autr/neu-dsk/hardware/schematic.pdf

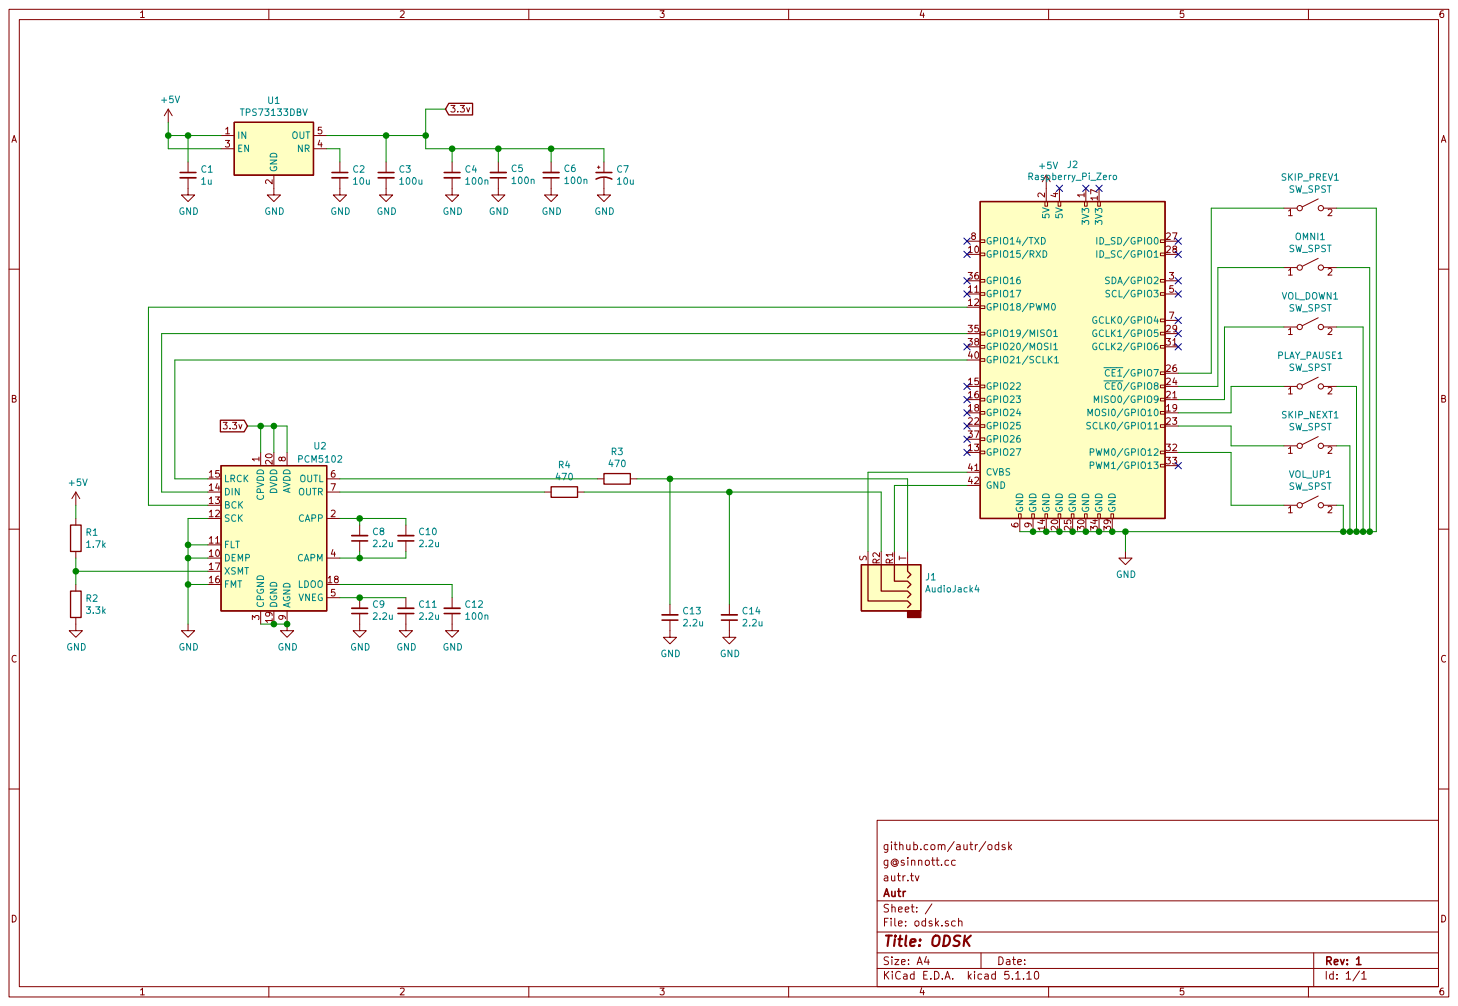
[picture p1: page 1]

4 GPIO21/SCLK1 40 CVBS 41 GND 42 SCL/GPIO3 5 GND

1 DEMP 10 FLT 11 SCK 12 BCK 13 DIN 14

3 CAPM 4 VNEG 5 OUTL 6 OUTR 7 AVDD

github.com/autr/odsk
File: odsk.sch Sheet: / Autr autr.tv g@sinnott.cc
