autr/neu-dsk/hardware/odsk.kicad_pcb

## KiCad design hardware/odsk.kicad_pcb (2022-07-06)

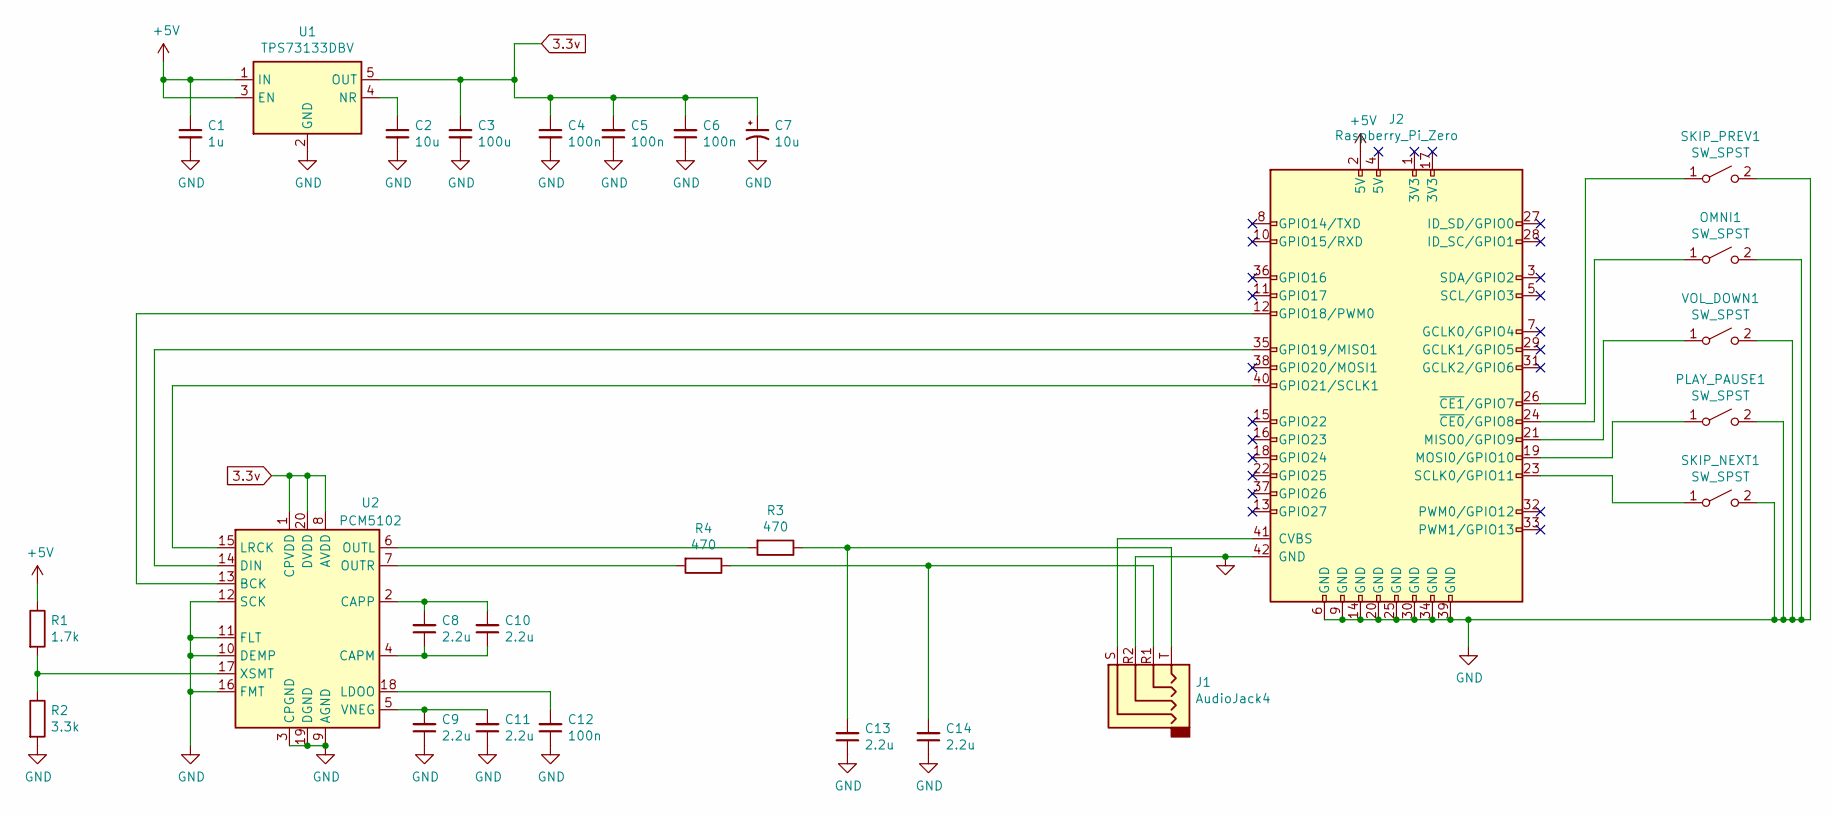
[picture p2: schematic odsk.kicad_sch]

Parts:
C1: 1u; C_0805_2012Metric_Pad1.18x1.45mm_HandSolder
C2: 10u; C_0805_2012Metric_Pad1.18x1.45mm_HandSolder
C3: 100u; C_1206_3216Metric_Pad1.33x1.80mm_HandSolder
C4, C5, C6, C12: 100n; C_0805_2012Metric_Pad1.18x1.45mm_HandSolder
C7: 10u; CP_Elec_5x5.4
C8, C9, C10, C11, C13, C14: 2.2u; C_0805_2012Metric_Pad1.18x1.45mm_HandSolder
J1: AudioJack4; TRRS-PJ-320A-Jack
J2: Raspberry_Pi_Zero
OMNI1: SW_SPST; SW_Tactile_SPST_Angled_PTS645Vx39-2LFS
PLAY_PAUSE1: SW_SPST; SW_Tactile_SPST_Angled_PTS645Vx39-2LFS
R1: 1.7k; R_0805_2012Metric_Pad1.20x1.40mm_HandSolder
R2: 3.3k; R_0805_2012Metric_Pad1.20x1.40mm_HandSolder
R3, R4: 470; R_0805_2012Metric_Pad1.20x1.40mm_HandSolder
SKIP_NEXT1: SW_SPST; SW_Tactile_SPST_Angled_PTS645Vx39-2LFS
SKIP_PREV1: SW_SPST; SW_Tactile_SPST_Angled_PTS645Vx39-2LFS
U1: TPS73133DBV; SOT-23-5
U2: PCM5102; TSSOP-20_4.4x6.5mm_P0.65mm
VOL_DOWN1: SW_SPST; SW_Tactile_SPST_Angled_PTS645Vx39-2LFS

Connections:
3.3v: C3.1, C4.1, C5.2, C6.2, C7.1, U1.5 (OUT), U2.1 (CPVDD), U2.8 (AVDD), U2.20 (DVDD)
+5V: C1.1, J2.2 (5V), R1.1, U1.1 (IN), U1.3 (EN)
unnamed: C2.1, U1.4 (NR)
unnamed: C8.1, C10.1, U2.4 (CAPM)
unnamed: C8.2, C10.2, U2.2 (CAPP)
unnamed: C9.2, C11.2, U2.5 (VNEG)
unnamed: C12.2, U2.18 (LDOO)
unnamed: C13.2, J1.T, R3.1
unnamed: C14.2, J1.R1, R4.1
unnamed: J1.S, J2.41 (CVBS)
unnamed: J2.12 (GPIO18/PWM0), U2.13 (BCK)
unnamed: J2.19 (MOSI0/GPIO10), PLAY_PAUSE1.1 (A)
unnamed: J2.21 (MISO0/GPIO9), VOL_DOWN1.1 (A)
unnamed: J2.23 (SCLK0/GPIO11), SKIP_NEXT1.1 (A)
unnamed: J2.24 (~CE0/GPIO8), OMNI1.1 (A)
unnamed: J2.26 (~CE1/GPIO7), SKIP_PREV1.1 (A)
unnamed: J2.35 (GPIO19/MISO1), U2.14 (DIN)
unnamed: J2.40 (GPIO21/SCLK1), U2.15 (LRCK)
unnamed: R1.2, R2.1, U2.17 (XSMT)
unnamed: R3.2, U2.6 (OUTL)
unnamed: R4.2, U2.7 (OUTR)

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
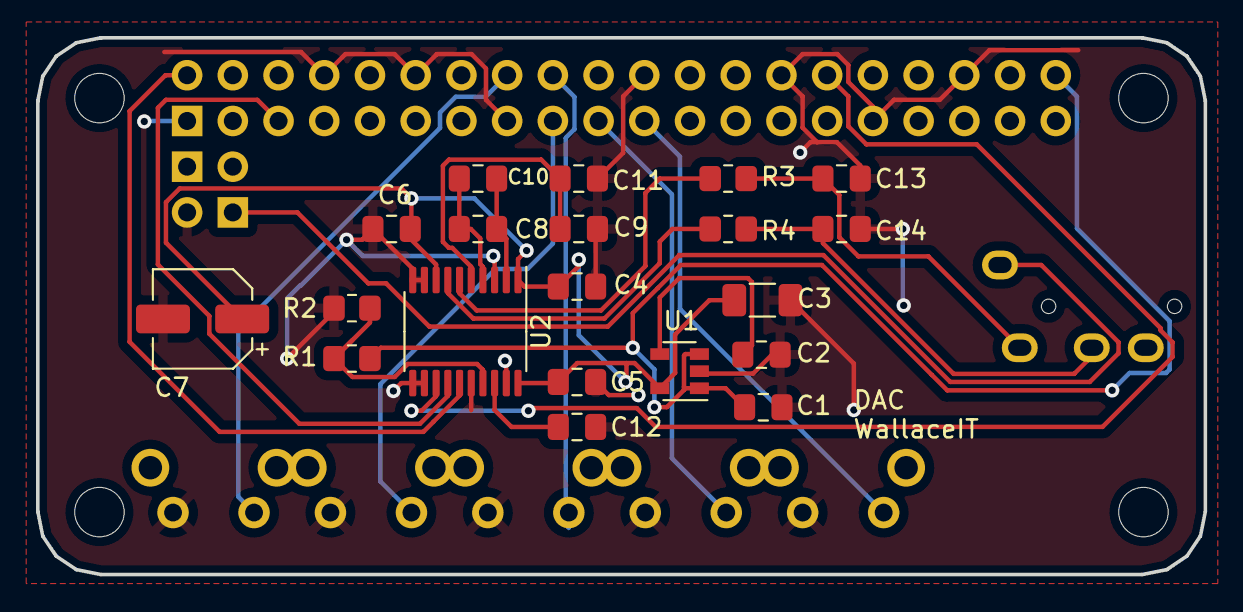
[picture p3: board odsk.kicad_pcb from above]

Board: 2 copper layers, 64.9 x 29.8 mm, 27 parts (0 on the bottom side), 22 nets.
