autr/neu-dsk/zero/index.js

const fs = require('fs')
const path = require('path')
const { spawn, execSync, exec }  = require('child_process')
const keypress = require('keypress')
const template = require('./template.svg.js')
const MODES = require('./modes.js')
const minimist = require('minimist')
const os = require('os')
const RPiGPIOButtons = require('rpi-gpio-buttons') 
const TESTCMD = `omxplayer --vol 1000 -b -o alsa:hw:0,0 /home/dietpi/dsk/samples/001.mov`
const mime = require('mime')
const InputEvent = require('input-event')

console.log(`[odsk] 👤  ${os.userInfo().username} ${process.env.USER || ''}`)

const INFO_RESTART = 0
const INFO_NO_CONFIG = 1

let ARGS = minimist( process.argv.slice(2) ) 

const VOLUP = 'VOLUP' 
const VOLDOWN = 'VOLDOWN'
const OMNI = 'OMNI'
const SKIPNEXT = 'SKIPNEXT'
const SKIPPREV = 'SKIPPREV'
const PLAYPAUSE = 'PLAYPAUSE'

let ENDOFDAYS = false // pi is rebooting
let KEYBOARDED = false // pi has keyboard attached

let DEBUG = ARGS?.d || false // dont reboot or show player
let FORCE = ARGS.f // force rerendering overlays

let IDX = 0 // video index
let PROC = null // video process

let VOL = -300 // current volume (read from disk)
let VOL_MIN = -4800 
let VOL_MAX = 0

let LIST = [] // list of video files
let GAP = 5000 // pause between files (read from disk)
let SPLASH = 'odsk' // boot splash (read from disk)
let TIMEOUT = null // overlay timeout
let MODE = 0 // video mode (read from disk)

const KEYS = {
    105: SKIPPREV,
    106: SKIPNEXT, 
    103: VOLUP,
    108: VOLDOWN,
    57: PLAYPAUSE,
    28: OMNI
}

console.log( `[odsk] 👁  commandline args ${JSON.stringify(ARGS)}`)

const BTNS = {
    12: VOLUP, // up
    9: VOLDOWN, // down
    8: OMNI, // enter
    11: SKIPNEXT, // right 
    10: PLAYPAUSE, // space
    7: SKIPPREV // left
}

console.log( `[odsk] 👁  using pins ${Object.keys(BTNS).join(',')}`)

let CMDS = {
    player: e => process.platform == 'darwin' ? 'mplayer' : 'omxplayer',
    settings: e => process.platform == 'darwin' ? '' : `-b --vol ${VOL} -o alsa:hw:0,0`
}
if ( !ARGS._[0] ) return console.error('[odsk] ❌  exiting - no folder specified')
let ROOT = path.resolve( ARGS._[0] )
let BIN = path.resolve( ROOT, './.bin' )
const DIRS = {
    ROOT,
    BIN,
    VOL: path.resolve( BIN, './volume.txt'),
    TIMEOUT: path.resolve( BIN, './timeout.txt'),
    SPLASH: path.resolve( BIN, './splash.txt')
}


const config = async e => {

    const str = await (await fs.readFileSync( `/boot/config.txt` )).toString()

    const a = str.indexOf(STR.BEGIN)
    const b = str.indexOf(STR.END) + STR.END.length
    const found = !(b < a || a == -1 || b == -1)

    return { a, b, found, str }
}


const save = async e => {

    ENDOFDAYS = true

	if (KEYBOARDED) {
		try {

   			keyboard.removeListener('keyup', onKeyup)
    		keyboard.removeListener('keypress', onKeypress)
		} catch(err) {}
	}

    let { str, found, a, b } = await config()

    let mode = MODES[MODE]
    let txt = mode.text

    if ( mode.type == 'CUSTOM' ) {
        let custom = path.resolve(ROOT, 'custom.txt')
        if ( await fs.existsSync( custom ) ) {
            mode.code = (await fs.readFileSync( custom )).toString()
            console.log(`[odsk] 🛠  using custom mode\n`, txt)
        } else {
            console.warn(`[odsk] ❌  could not find a custom.txt at ${custom}`)
            return (await show( 'info', INFO_NO_CONFIG ))

        }
    }

    let neu = `${STR.BEGIN}
${STR.MODE}${MODE}
# ${txt.replaceAll('\n', ' - ')}
${mode.code}
${STR.END}`
    let piece
    if (!found) {
        str += neu 
    } else {
        piece = str.substring(a, b)
        str = str.replace(piece, neu)
    }

    const ending = s => (s.substring( s.length - 40, s.length ))

    await fs.writeFileSync( '/boot/config.txt', str )
    console.log(`[odsk] 🗳  wrote mode ${MODE} to boot config\n`, neu)

    await KILL.player()

    // TODO: this is a hacky fix
    
    await show('info', INFO_RESTART)
    
    setTimeout( async e => {
        console.log(`[odsk] ⚡️  rebooting now`)
        if (!DEBUG) await execSync(`sudo reboot now`) 
    }, GAP)
}


async function onReleased( PIN ) {

    if (ENDOFDAYS) return

    console.log(`[odsk] ❄️  released ${PIN.toLowerCase()}`)
    if ( PIN == OMNI ) {
        clearTimeout( RESET_TIMEOUT )
        MODE_TOGGLE = !MODE_TOGGLE
        await modish( 0 )
        await KILL.player()
    }
}

let RESET_TIMEOUT = null
const RESET_TIME = 4500


async function onPressed( PIN ) {

    if (ENDOFDAYS) return

    console.log(`[odsk] 🔆  pressed ${PIN.toLowerCase()}`)

    if ( PIN == SKIPPREV ) {
        if (!MODE_TOGGLE) await skip(-1)
        if (MODE_TOGGLE) await modish(-1)
    }
    if ( PIN == SKIPNEXT ) {
        if (!MODE_TOGGLE) await skip(1)
        if (MODE_TOGGLE) await modish(1)
    }

    if ( PIN == VOLDOWN || PIN == VOLUP ) {
        if (!MODE_TOGGLE && PROC) {
            if ( PIN == VOLDOWN && VOL >= VOL_MIN + 300 ) {
                VOL -= 300
                console.log(`[o-disk] 🔊  ${VOL/1000}db ${VOL}`)
                await PROC.stdin.write('-')
            }
            if ( PIN == VOLUP && VOL <= VOL_MAX - 300 ) {
                VOL += 300
                console.log(`[o-disk] 🔊  ${VOL/1000}db ${VOL}`)
                await PROC.stdin.write('+')
            }
            await fs.writeFileSync( DIRS.VOL, VOL + '' )
        } else {
            // if ( PIN == VOLDOWN ) await modish(-1)
            // if ( PIN == VOLUP ) await modish(1)
        }
    }

    if ( PIN == PLAYPAUSE ) {
        if (PROC) await PROC.stdin.write(' ')
        if (!PROC && MODE_TOGGLE) {
            console.log('[o-disk] 🛰  saving settings')
            await save()
        }
    }

    if ( PIN == OMNI ) {
        if (!PROC) clearTimeout(TIMEOUT)
        RESET_TIMEOUT = setTimeout( async e => {
            console.log('[o-disk] 🛰  pressed and held - 720p / NTSC')
            MODE = 0
            await save()
        }, RESET_TIME)
    }


}

const gpio = async e => {

    let buttons = new RPiGPIOButtons( { 
        pins: Object.keys(BTNS),
        mode: RPiGPIOButtons.MODE_BCM,
        usePullUp: false,
        debounce: 10,
        pressed: 10,
        clicked: 10
    })
    buttons.on('error', async err => ( console.log('[odsk] 🚨  button error', err) ))
    buttons.on('pressed', pin => onReleased(BTNS[pin]))
    buttons.on('released', pin => onPressed(BTNS[pin]))
    buttons.init().catch(err => ( console.error('[odsk] ❌  error initialising buttons:', err.message)))
}

try {

    const keyboard = new InputEvent.Keyboard( new InputEvent('/dev/input/event0') ) 

    async function onKeyup(e) {
        if (ENDOFDAYS) return
        console.log(`[odsk] 🎹  keyup ${KEYS[e.code]}`)
        onReleased( KEYS[e.code] )
    }

    async function onKeypress(e) {
        if (ENDOFDAYS) return
        console.log(`[odsk] 🎹  keypress ${KEYS[e.code]}`)
        onPressed( KEYS[e.code] )
    }

    keyboard.on('keyup', onKeyup)
    keyboard.on('keypress', onKeypress)

    KEYBOARDED = true

} catch(err) {
    console.log(`[odsk] 🌶  no keyboard attached ${err.message}`)
}

console.log(`[odsk] 🛣  using paths\n------------`)
Object.entries(DIRS).forEach( o => ( console.log(`${o[0]} ${o[1]}\n------------`) ) )

const KILL = {
    fbi: async e => {
        console.log('[odsk] ⚰️  killing framebuffer')
        try { 
            await execSync( `sudo pkill fbi`) 
        } catch(err) {}
    },
    node: async e => {
        console.log('[odsk] ⚰️  killing node')
        try {  
            await execSync( `sudo pkill node`)
        } catch(err) {}
    },
    player: async e => {
        console.log('[odsk] ⚰️  killing player')
        try { 
            await execSync( `pkill ${CMDS.player()}`) 
        } catch(err) {}
    }
}

const skip = async num => {
    IDX += num
    if (IDX < 0) IDX = LIST.length - 1
    if (IDX >= LIST.length) IDX = 0
    console.log(`[odsk] ⏳  switched to ${IDX}/${LIST.length}` )
    await start()

}
const toggle = async e => {
    console.log('[odsk] 🏁  pause / play')
    if (PROC) PROC.stdin.write(' ')
}


const show = async (type, idx) => {


    await KILL.fbi()
    let img = `${type}-${idx}.png`
    console.log(`[odsk] 🖼  displaying ${img}`)
    if (!DEBUG) await execSync( `sudo fbi -d /dev/fb0 -T 1 --nocomments --noverbose --cachemem 1 ${path.resolve(DIRS.BIN, `${img} > /dev/null 2>&1`)}`)
}

let MODE_TOGGLE = false

const modish = async num => {
    MODE += num
    if (MODE < 0) MODE = MODES.length - 1
    if (MODE >= MODES.length) MODE = 0
    if (MODE_TOGGLE) {
        await show('mode', MODE)
        await KILL.player()
    } else {
        await start()
    }
}

const start = async e => {

    if (TIMEOUT) {
        clearTimeout( TIMEOUT )
        TIMEOUT = null
    }

    await KILL.player()
    await show('video', IDX)

    PROC = null

    TIMEOUT = setTimeout( async ee => {

        const url = path.resolve(DIRS.ROOT, LIST[IDX].name )
        let ex = `${CMDS.player()} ${CMDS.settings()} ${url}`

        console.log(`[odsk] 🎬  playing ${ path.basename(url) }`)
        console.log(`[odsk] 🎬  ${ex}`)

        if (!DEBUG) {

            PROC = exec( ex, async (error, stdout, stderr) => {

                if (ENDOFDAYS) return

                const data = {error,stdout,stderr}
                let type = error ? 'error' : stdout ? 'stdout' : stderr ? 'stderr' : ''
                const o = data[type]
                if (type == 'error') type = 'exited'
                console.log(`[${CMDS.player()}] 📼   player ${type}`, o.code, o.killed || '', o.signal || '' )
     
                PROC = null
                if (type == 'stdout') {
                    console.log(`[${CMDS.player()}] 📼   skipping to next from stdout`)
                    await skip(1)
                }
            })
        }

    }, GAP)

}

const create = async (type, list, PLYMOUTH) => {

    if (ENDOFDAYS) return

    let count = 0
    for (let i = 0; i < list.length; i++ ) {
        const o = list[i]
        const markup = template(o.text)
        let svg = path.resolve(DIRS.BIN, `${type}-${i}.svg` )
        let png = path.resolve(DIRS.BIN, `${type}-${i}.png` )

        if (PLYMOUTH) {
            svg = '/usr/share/plymouth/themes/pix/splash.svg'
            png = '/usr/share/plymouth/themes/pix/splash.png'
            console.log(`[odsk] 🍇  using plymouth ${png}`)
        }

        let hasChanged = false

        if (await fs.existsSync(svg)) {
            const s = await ( await fs.readFileSync( svg ) ).toString()
            hasChanged = markup != s
        } else {
            hasChanged = true
        }

        if (!(await fs.existsSync( png )) || FORCE || hasChanged ) {
            const cmd = `MAGICK_FONT_PATH=/usr/share/fonts/truetype/custom rsvg-convert ${svg} > ${png}` 
            await fs.writeFileSync( svg, markup )
            await execSync( cmd )
            console.log(`[odsk] 🖼  ${png}`)
            count += 1
        }



    }
    if (count > 0) console.log(`[odsk] ✅  ${count} new ${type} overlays`)
}

let STR = {
    BEGIN: '# <DSK>',
    END: '# </DSK>',
    MODE: '# MODE='
}

const patch = async e => {
    const res = (await execSync('python ../libs/buttons.py')).toString()
    console.log(`[odsk] 🐍  gpio buttons patch: ${res.replaceAll('\n', ' ')}`)
}
const wait = async ms => ( new Promise(resolve => setTimeout(resolve, ms) ) )

const run = async e => {


    await KILL.fbi()
    await KILL.player()
    await gpio()
    await patch()

    // await wait(1000)

    // let PINS = Object.keys(BTNS)
    // for (let i = 0; i < PINS.length; i++){
    //     let PIN = PINS[i]
    //     console.log(`[odsk] ♻️  refreshing pin ${PIN}`)
    //     let cmds = {
    //         unexport: `echo ${PIN} > /sys/class/gpio/unexport`,
    //         export: `echo ${PIN} > /sys/class/gpio/export`,
    //         direction: `echo in > /sys/class/gpio/gpio${PIN}/direction`
    //     }
    //     try { await execSync( cmds.unexport ) } catch(err) { console.error('[odsk] ❌ ', err.message) }
    //     try { await execSync( cmds.export ) } catch(err) { console.error('[odsk] ❌ ', err.message) }
    //     try { await execSync( cmds.direction ) } catch(err) { console.error('[odsk] ❌ ', err.message) }
    // }

    if ( !(await fs.existsSync( DIRS.BIN )) ) {
        console.log('[odsk] creating bin...')
        await fs.mkdirSync( DIRS.BIN )
    }

    // READ VOL

    try {
        if ( !(await fs.existsSync( DIRS.VOL )) ) await fs.writeFileSync( DIRS.VOL, VOL + '' )
        VOL = parseInt( await (await fs.readFileSync( DIRS.VOL )).toString() )
        console.log(`[odsk] 🔊  volume.txt ${VOL}`)
    } catch(err) {
        return console.error(`[odsk] could not load volume.txt ${err.message}`)
    }

    // READ TIMEOUT / GAP

    try {
        if ( !(await fs.existsSync( DIRS.TIMEOUT )) ) await fs.writeFileSync( DIRS.TIMEOUT, GAP + '' )
        GAP = parseInt( await (await fs.readFileSync( DIRS.TIMEOUT )).toString() )
        console.log(`[odsk] ⏱  timeout.txt ${VOL}`)
    } catch(err) {
        return console.error(`[odsk] ❌  could not load timeout.txt ${err.message}`) 
    }

    // READ SPLASH

    try {
        SPLASH = await (await fs.readFileSync( DIRS.SPLASH )).toString()
        console.log(`[odsk] 💦  splash.txt ${SPLASH}`)
    } catch(err) {
        console.error(`[odsk] 💦  using default splash ${SPLASH}`) 
    }

    // READ PLAYLIST 

    try {
        LIST = await Promise.all( (await fs.readdirSync( DIRS.ROOT )).filter( url => ((mime.getType(url)||'').indexOf('video') != -1)).map( async url => {

            const TXT = path.resolve( DIRS.ROOT, path.parse(url).name + '.txt' )
            console.log(`[odsk] 💿  ${TXT} added to playlist`)
            if (await fs.existsSync( TXT )) {
                return { text: (await fs.readFileSync( TXT )).toString(), name: url }
            }
            return url
        }) )

    } catch(err) {
        return console.error(`[odsk] ❌  could read lists at ${DIRS.ROOT}`)
    }

    // READ MODE

    try {
        const { str, a, b, found } = await config() 

        if ( !found ) {
            MODE = 0
            console.log('[odsk] 🤖  no explicit mode set from config (auto)')
        } else {
            const c = str.indexOf(STR.MODE)
            MODE = parseInt( str.substring(c + STR.MODE.length).split('\n')[0] )
            console.log(`[odsk] 🤖  mode from boot config ${MODES[MODE].text.replaceAll('\n', ' ')}`)
        }

    } catch(err) {
        return console.error(`[odsk] could not load boot config`)
    }

    console.log('[odsk] 🎨  generating video overlays\n------------')
    LIST.forEach( o => (console.log(`${o?.name}\n${o?.text}\n------------`)))
    await create('video', LIST)
    console.log('[odsk] 🎨  generating node overlays') 
    await create('mode', MODES)
    console.log('[odsk] 🎨  generating info overlays')
    await create('info', [ 
        { text: 'Restarting'},
        { text: 'No config.txt\nAdd to disk root to enable'}
    ])
    console.log('[odsk] 🎨  generating splash overlay')
    await create('splash', [{ text: SPLASH }], true)
    
    await start()
}

run()


/* 
    OMXPLAYER
    1 Increase Speed
    2 Decrease Speed
    j Previous Audio stream
    k Next Audio stream
    i Previous Chapter
    o Next Chapter
    n Previous Subtitle stream
    m Next Subtitle stream
    s Toggle subtitles
    q Exit OMXPlayer
    Space or p Pause/Resume
    - Decrease Volume
    + Increase Volume
    Left Seek -30
    Right Seek +30
    Down Seek -600
    Up Seek +600
*/
