autr/neu-dsk/(commit log)

2021-06-30 fix pins mixup, emojis, finalise
    [index.js]
2021-07-08 faster switching zero
2022-04-05 update circuit to v2.0
    [odsk.kicad_pcb, odsk.sch]
2022-04-05 add jlc pcba files
    [bom_jlc.csv, odsk.csv, pos_jlc.csv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]
2022-04-05 remove unused files
    [odsk.csv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]
2022-04-12 update cap footprint
    [bom_jlc.csv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]
2022-04-19 update silkscreen v2.1
    [odsk.kicad_pcb]
2022-04-19 gpio numbering & labels
    [odsk.kicad_pcb]
2022-05-18 jlc bom
    [bom_jlc.csv]
2022-07-06 [V2.2] Swap TRRS R1/R2, connect 5V, CVBS GND, reposition buttons
    [odsk.kicad_pcb, odsk.kicad_sch]
